MAKERS-DEVELOPMENT-GROUP/MDG-ENDER-3-PRO_V2-PROJECT/BOM/MDG ENDER 3 PRO_V2 - BOM R0.xlsx

Sheet: READ ME
Thank you for your interest in MAKERS DEVELOPMENT GROUP, LLC'S ENDER 3 PRO / V2 upgrade project.
AQUIRING PARTS FOR THE BUILD
There are many ways to build your MDG ENDER 3.
1.) Buy a Complete Kit directly from our webstore
This is the easiset option as all required parts will come from a single purchase from our webstore.
As such this is our recommneded option.
2.) Buy each axis upgrade individually from our webstore
This is the option if you wish to upgrade over time. If you go down this path we recommend upgrading
the Y-axis first, X-axis second, and Z-axis third. You can purchase each axis upgrade kit directly from our webstore
3.) Buy aluminum parts & 3D printed parts kit from our store.
This option is for those that enjoy sourcing all the componets themselves.
Please use our affiliate links so you can support our business and enable us to provide more designs.
For amazon links please note the link expires after 24 hours so please make your purchase within that
time period so we can get credit or re-click links prior to purchase.
4.) Buy aluminum parts from our webstore & 3D print your own parts
This option is for those that enjoy sourcing all the componets and printing their own parts.
Please use our affiliate links so the can support our business and enable us to provide more designs.
For amazon links please note the link expires after 24 hours so please make your purchase within that
time period so we can get credit or re-click links prior to purchase.
***********************************************************************************************
Please note MDG makes all our own aluminum parts, we do not allow others to make them on our
behalf, please support our business by buying all aluminum parts directly from us. Reverse
engineering of any MDG parts is forebidden.
See LEGAL section for full tems of use pertaining to this BOM

Sheet: MDG ENDER 3 PRO_V2 - BOM
MAKERS DEVELOPMENT GROUP, LLC
MDG ENDER 3 PRO / V2 PROJECT - BILL OF MATERIAL
REV: 0
ITEM | QTY | PART NUMBER | DESCRIPTION | COST | EXT COST
 | 1 | 10-0008 | MDG X-AXIS TIMING BELT CLAMP (https://www.makersdevelopmentgroup.com/product-page/gt2-timing-belt-clamp-vertical-6mm) | $3.93 | $3.93
 | 3 | 10-0009 | MDG Z AXIS SPACER (https://www.makersdevelopmentgroup.com/product-page/mdg-z-axis-spacer-cr-10) | $4.95 | $14.85
 | 1 | 10-0012 | MDG Z RAIL UPPER SUPPORT, LEFT, CR10 / ENDER 3 | 3.53 | $3.53
 | 1 | 10-0013 | MDG Z RAIL UPPER SUPPORT, RIGHT, CR10 / ENDER 3 | 3.53 | $3.53
 | 1 | 10-0022 | MDG DUAL-X LINEAR RAIL PLATE, 300 MM, ENDER 3 | 59.95 | $59.95
 | 1 | 10-0023 | MDG-TOOL BASE, DUAL-X, ENDER 3 | 24.95 | $24.95
 | 1 | 10-0024 | DIRECT DRIVE EXTRUDER MOUNT, ENDER 3 / CR-10 / MICRO-SWISS | 13.95 | $13.95
 | 2 | 10-0026 | MDG DUAL-Y LINEAR RAIL MOUNT L&R, ENDER 3 PRO LW | 37.95 | $37.95
 | 2 | 10-0027 | MDG DUAL-Y END STOP, ENDER 3 PRO / V2 | 3.53 | $7.06
 | 1 | 10-0028 | MDG ADJUSTABLE Y LIMIT SWITCH PLATE, ENDER 3 PRO / V2 | 3.53 | $3.53
 | 1 | 10-0040 | MDG X END STOP, LEFT, ENDER 3 PRO / V2 | 3.53 | $3.53
 | 2 | 10-0041 | MDG X END STOP, RIGHT, ENDER 3 PRO / V2 | 3.53 | $7.06
 | 1 | 10-0042 | MDG X LIMIT SWITCH PLATE, ENDER 3 PRO / V2 | 3.53 | $3.53
 | 1 | 10-0044 | MDG Z RAIL LOWER SUPPORT, LEFT, ENDER 3 PRO / V2 | 3.53 | $3.53
 | 1 | 10-0045 | MDG Z RAIL LOWER SUPPORT, RIGHT, ENDER 3 PRO / V2 | 3.53 | $3.53
 | 2 | 98952A114 | HEX STANDOFF (https://www.mcmaster.com/98952A114/) | 1.84 | $3.68
 | 1 | GT2B-2P-6W-1M | GT2 BELT (https://amzn.to/38wEzzP) | $13.99 | $13.99
 | 30 | HLN-M3X0.5 | HEX LOCK NUT (https://amzn.to/35UMeI6) | $6.99 | $6.99
 | 3 | HLN-M5X0.8 | HEX LOCK NUT (https://amzn.to/3pOCWFH) | $8.19 | $8.19
 | 1 | HLN-M6X1 | HEX LOCK NUT (https://amzn.to/3ft75W0) | $6.28 | $6.28
 | 2 | M119A2A153 | SHCS | $10.59 | $10.59
 | 8 | M119A2A159 | SHCS (https://amzn.to/2KQQvEC) | $8.19 | $8.19
 | 86 | M119A2A161 | SHCS (https://amzn.to/2WPxBQV) | $7.89 | $7.89
 | 7 | M119A2A163 | SHCS (https://amzn.to/35WZcoV) | $8.98 | $8.98
 | 12 | M119A2A178 | SHCS (https://amzn.to/398aKaN) | $11.79 | $11.79
 | 2 | M119A2A179 | SHCS (https://amzn.to/38CBIFw) | $8.49 | $8.49
 | 3 | M119A2A188 | SHCS (https://amzn.to/35UjjUH) | $10.59 | $10.59
 | 16 | M121A2A161 | FHCS (https://amzn.to/2KyT4eC) | $6.29 | $6.29
 | 6 | M121A2A163 | FHCS (https://amzn.to/2Jhz8MC) | $6.69 | $6.69
 | 4 | M12A5C3 | PLAIN WASHER (https://amzn.to/3nUd3T7) | $4.99 | $4.99
 | 4 | M12A5C5 | PLAIN WASHER (https://amzn.to/3kXEGbZ) | $7.29 | $7.29
 | 2 | MDG-LR09-1H-300 | LINEAR RAIL, 9MM X 300MM, SS (https://amzn.to/3plMVkD) | 21.99 | $43.98
 | 2 | MDG-LR-12-1H-300 | LINEAR RAIL, 12MM X 300MM (https://amzn.to/2KpyL3j) | 19.99 | $39.98
 | 2 | MDG-LR12-1H-350 | LINEAR RAIL, 12MM X 350MM (https://amzn.to/3nNH7jn) | 21.99 | $43.98
 | 1 | SB-A201 | SHOULDER BOLT (https://www.mcmaster.com/92981A201/) | $1.57 | $1.57
 | 1 | SBS-A263 | SHIM (https://www.mcmaster.com/91437A263/) | $9.60 | $9.60
 | 1 | SBS-A282 | SHIM (https://www.mcmaster.com/91437A282/) | $12.75 | $12.75
 | 52 | TN-2020-M3 | T-NUT, 2020 (https://amzn.to/3pWzc55) | $7.99 | $7.99
 | 10 | TN-2020-M5 | T-NUT, 2020 (https://amzn.to/2IViW3E) | $7.99 | $7.99
 |  |  |  |  | $493.16

Sheet: LEGAL
LEGAL TERMS
THIS BILL OF MATERIAL AND DATA EMBODY PROPRIETARY INFORMATION WHICH IS THE CONFIDENTIAL
PROPERTY OF MAKERS DEVELOPMENT GROUP, LLC AND SHALL NOT BE COPIED, REPRODUCED, DISCLOSED
TO OTHERS, OR OTHERWISE USED IN WHOLE OR IN PART IN ANY MATTER PREJUDICIAL TO THE
INTERESTS OF MAKERS DEVELOPMENT GROUP, LLC WITHOUT EXPRESS WRITTEN CONSENT OF MAKERS
DEVELOPMENT GROUP, LLC. MAKERS DEVELOPMENT GROUP, LLC EXPRESSLY RESERVES ALL DESIGN,
MANUFACTURING USE, REPRODUCTION AND SALES RIGHTS IN AND TO ALL INFORMATION CONTAINED IN
OR DISCLOSED BY THIS DOCUMENT. THIS BILL OF MATERIAL IS LOANED IN CONFIDENCE WITH THE
UNDERSTANDING IT SHALL BE RETURNED ON DEMAND. ACCEPTANCE OF THIS BILL OF MATERIAL SHALL
BE CONSTRUED AS AN AGREEMENT TO OBSERVE THE FOREGOING CONDITIONS AND AS AN ADMISSION
THAT MAKERS DEVELOPMENT GROUP, LLCIS THE EXCLUSIVE OWNER OF THIS BILL OF MATERIAL.
"MAKERS DEVELOPMENT GROUP, LLCEXPRESSLY RESERVES ALL DESIGN, MANUFACTURING USE,
REPRODUCTION, SALES RIGHTS IN AND TO ALL INFORMATION CONTAINED OR DISCLOSED BY THIS
DOCUMENT."
