MAKERS-DEVELOPMENT-GROUP/MDG-ENDER-3-PRO_V2-PROJECT/STL/10-0024#2.stl

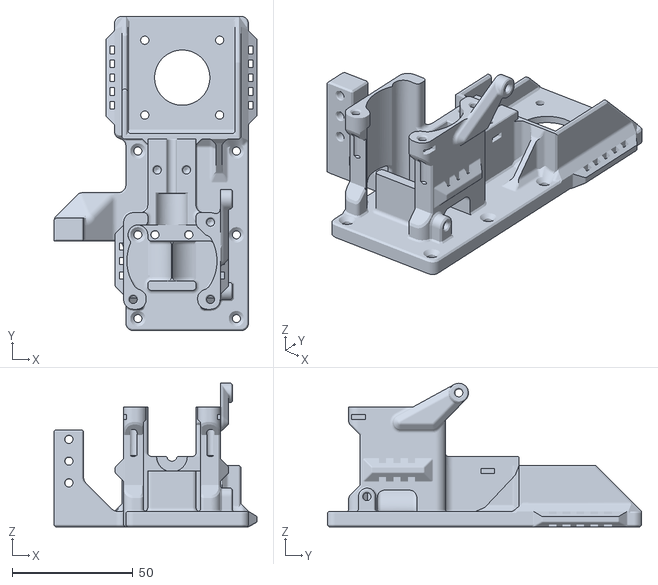
[picture p2: CAD file, 2021-04-25]
STL/10-0024#2.stl
84.0 x 130.2 x 59.4
