MAKERS-DEVELOPMENT-GROUP/MDG-ENDER-3-PRO_V2-PROJECT/STL/10-0024#1.stl

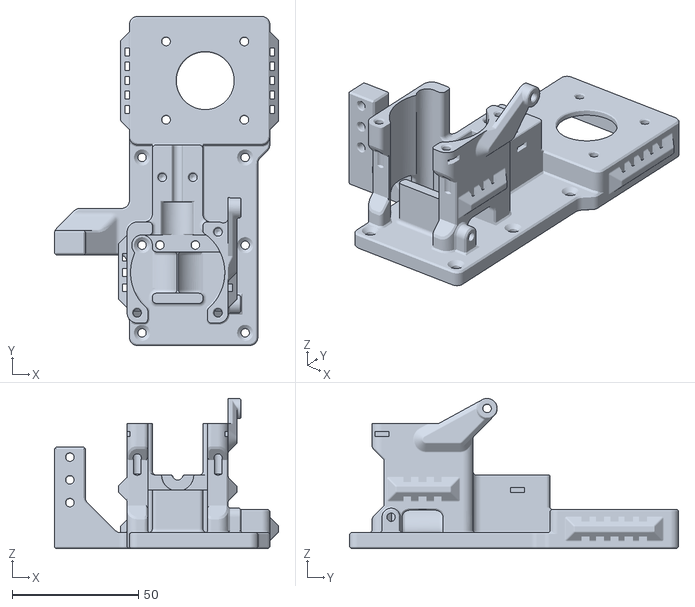
[picture p3: CAD file, 2021-04-25]
STL/10-0024#1.stl
88.8 x 130.2 x 59.4
