MAKERS-DEVELOPMENT-GROUP/MDG-ENDER-3-PRO_V2-PROJECT/STL/10-0024B#0.stl

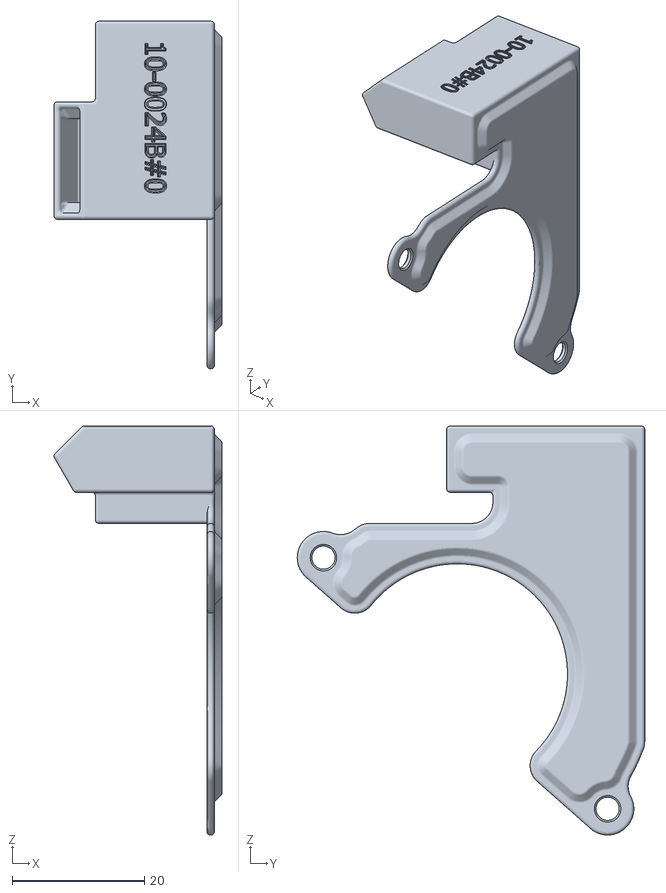
[picture p4: CAD file, 2021-04-25]
STL/10-0024B#0.stl
25.4 x 52.6 x 61.9
