MAKERS-DEVELOPMENT-GROUP/MDG-ENDER-3-PRO_V2-PROJECT/STL/10-0024A#0.stl

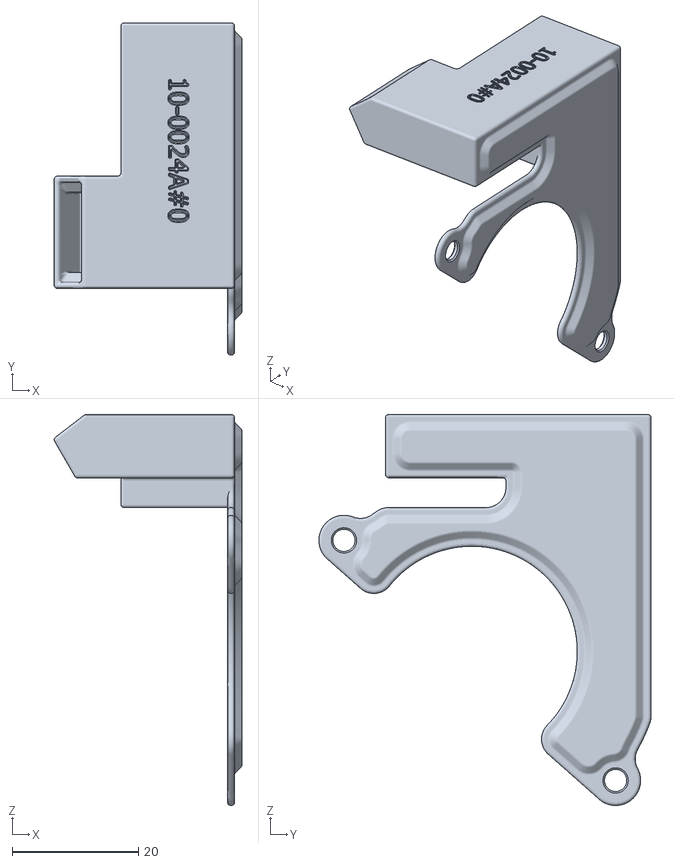
[picture p6: CAD file, 2021-04-25]
STL/10-0024A#0.stl
29.7 x 52.6 x 61.9
