MAKERS-DEVELOPMENT-GROUP/MDG-ENDER-3-PRO_V2-PROJECT/STL/10-0045.stl

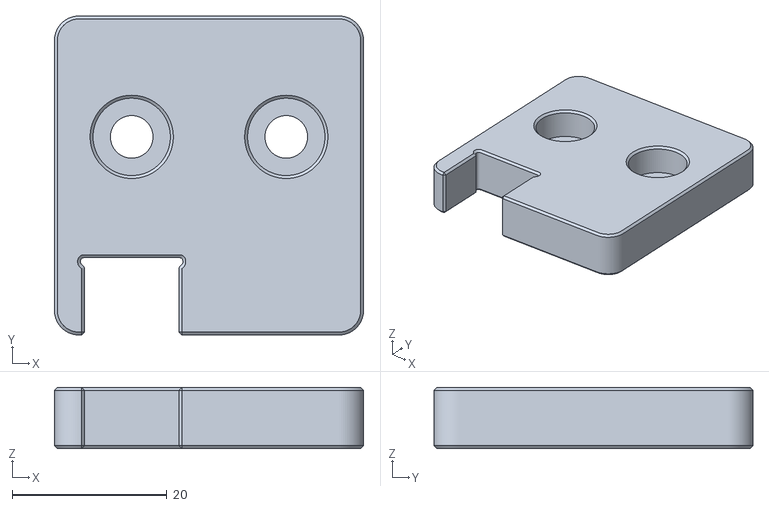
[picture p7: CAD file, 2021-02-17]
STL/10-0045.stl
40.0 x 41.3 x 7.94
