MAKERS-DEVELOPMENT-GROUP/MDG-ENDER-3-PRO_V2-PROJECT/STL/10-0012.stl

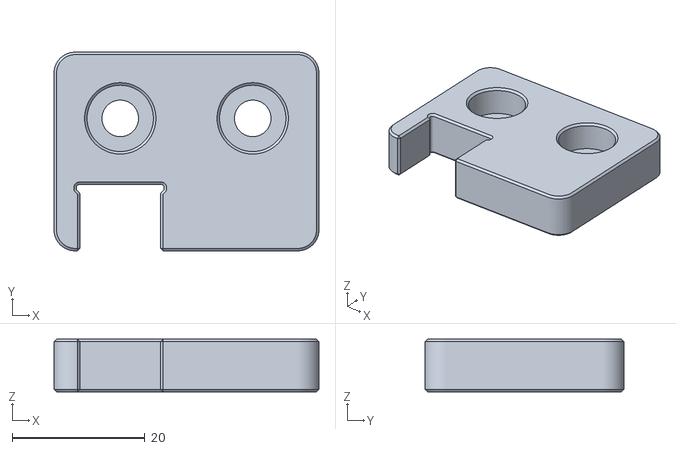
[picture p8: CAD file, 2021-02-17]
STL/10-0012.stl
40.0 x 30.0 x 7.94
