MAKERS-DEVELOPMENT-GROUP/MDG-ENDER-3-PRO_V2-PROJECT/STL/10-0041.stl

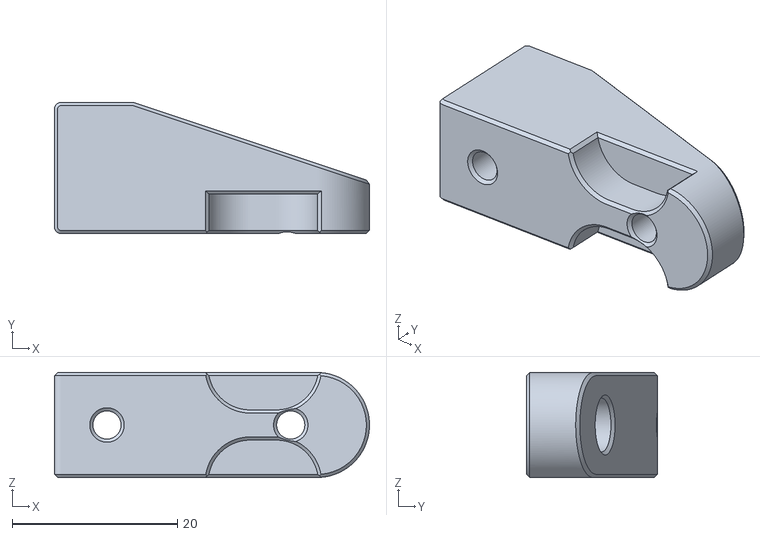
[picture p9: CAD file, 2021-02-17]
STL/10-0041.stl
38.1 x 15.9 x 12.7
