MAKERS-DEVELOPMENT-GROUP/MDG-ENDER-3-PRO_V2-PROJECT/STL/10-0028.stl

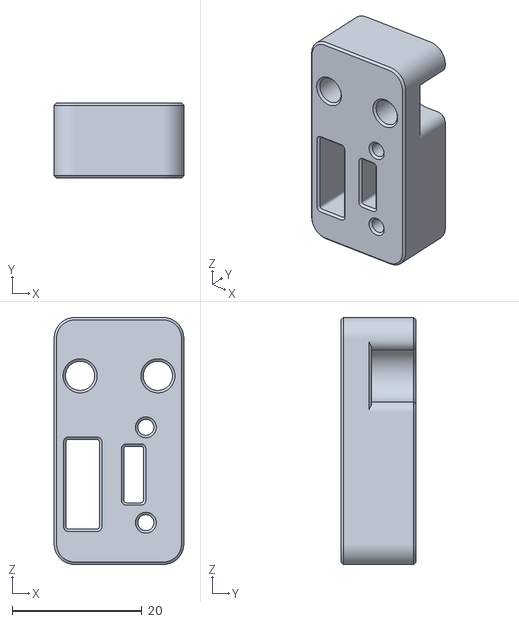
[picture p10: CAD file, 2021-02-17]
STL/10-0028.stl
20.0 x 11.6 x 38.1
