MAKERS-DEVELOPMENT-GROUP/MDG-ENDER-3-PRO_V2-PROJECT/STL/10-0040.stl

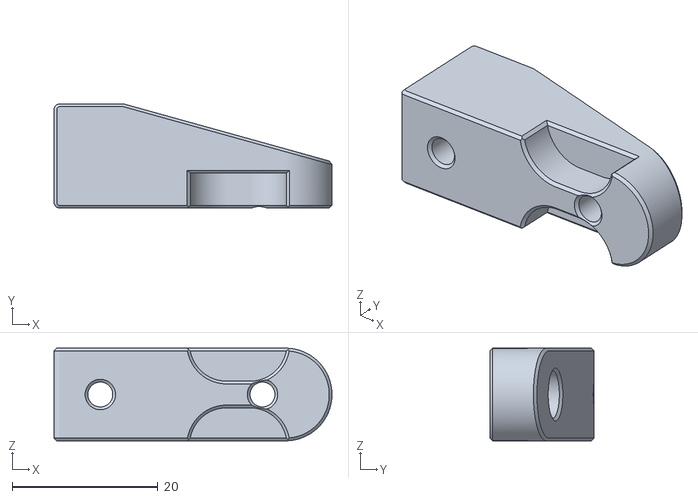
[picture p11: CAD file, 2021-02-17]
STL/10-0040.stl
38.1 x 14.3 x 12.7
