MAKERS-DEVELOPMENT-GROUP/MDG-ENDER-3-PRO_V2-PROJECT/STL/10-0043.stl

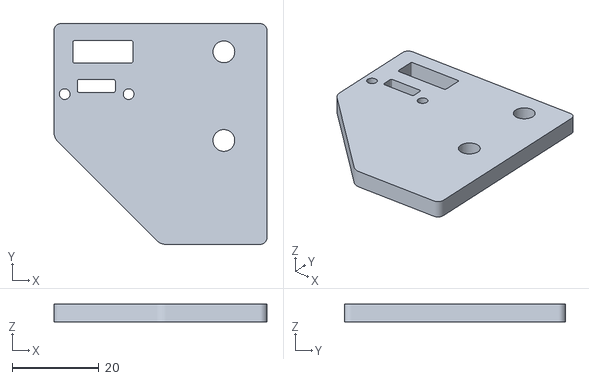
[picture p12: CAD file, 2021-02-17]
STL/10-0043.stl
49.0 x 50.8 x 4.06
