MAKERS-DEVELOPMENT-GROUP/MDG-ENDER-3-PRO_V2-PROJECT/STL/10-0024A#1.stl

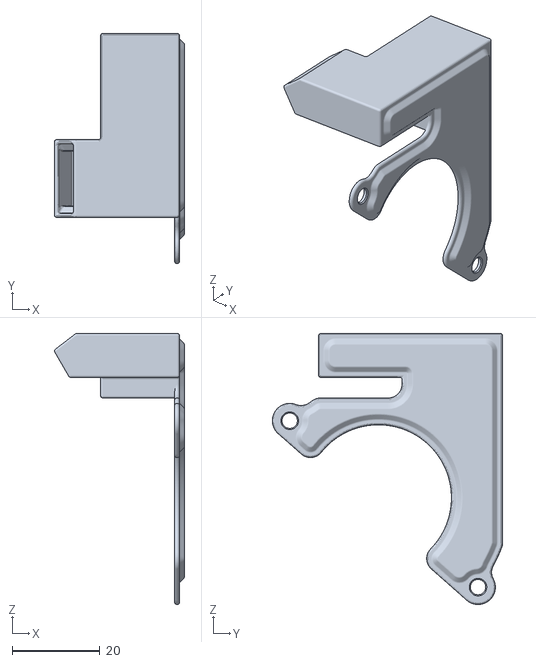
[picture p13: CAD file, 2021-02-17]
STL/10-0024A#1.stl
29.7 x 52.6 x 61.9
