MAKERS-DEVELOPMENT-GROUP/MDG-ENDER-3-PRO_V2-PROJECT/STL/10-0042.stl

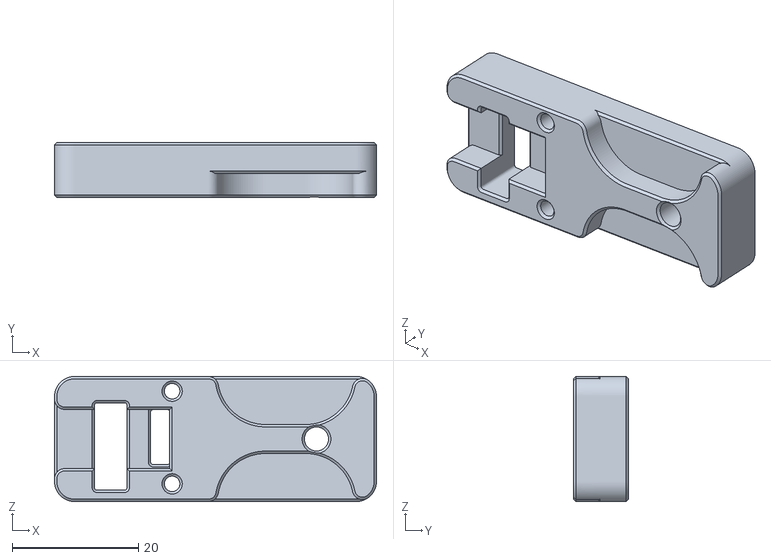
[picture p14: CAD file, 2021-02-17]
STL/10-0042.stl
51.1 x 8.73 x 19.8
