MAKERS-DEVELOPMENT-GROUP/MDG-ENDER-3-PRO_V2-PROJECT/STL/10-0027.stl

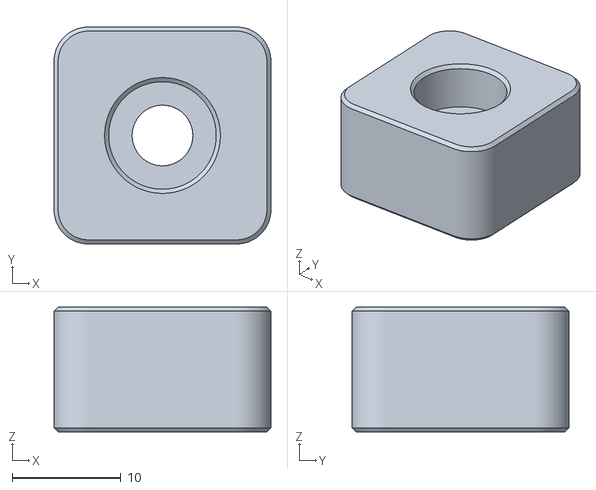
[picture p15: CAD file, 2021-02-17]
STL/10-0027.stl
20.0 x 20.0 x 11.5
