MAKERS-DEVELOPMENT-GROUP/MDG-ENDER-3-PRO_V2-PROJECT/STL/10-0048.stl

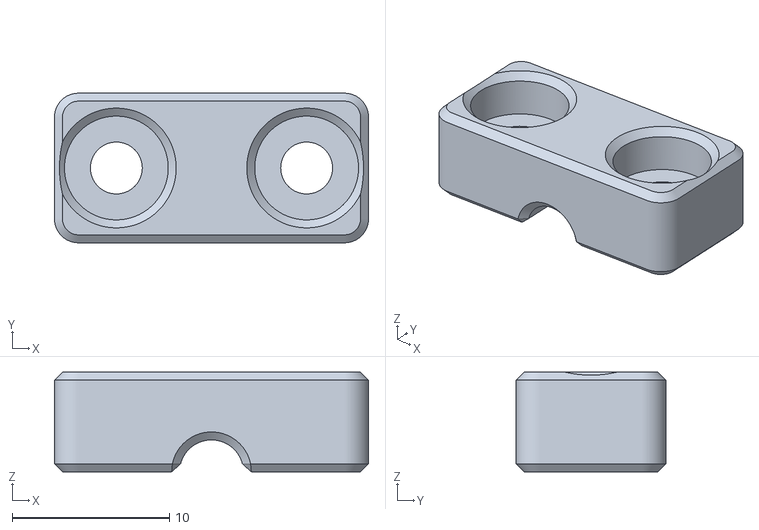
[picture p16: CAD file, 2021-02-17]
STL/10-0048.stl
20.0 x 9.52 x 6.35
