MAKERS-DEVELOPMENT-GROUP/MDG-ENDER-3-PRO_V2-PROJECT/STL/10-0049.stl

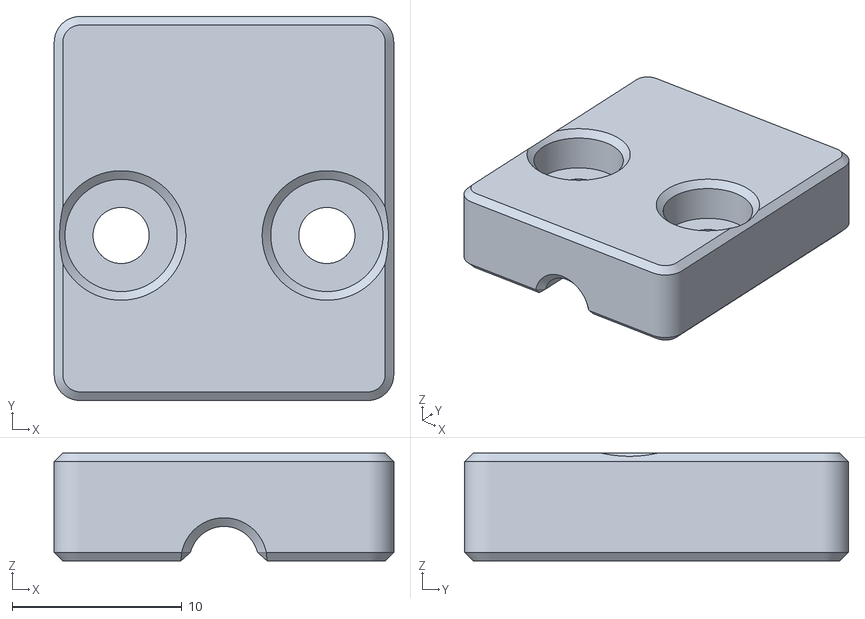
[picture p17: CAD file, 2021-02-17]
STL/10-0049.stl
20.0 x 22.6 x 6.35
