MAKERS-DEVELOPMENT-GROUP/MDG-ENDER-3-PRO_V2-PROJECT/STL/10-0050.stl

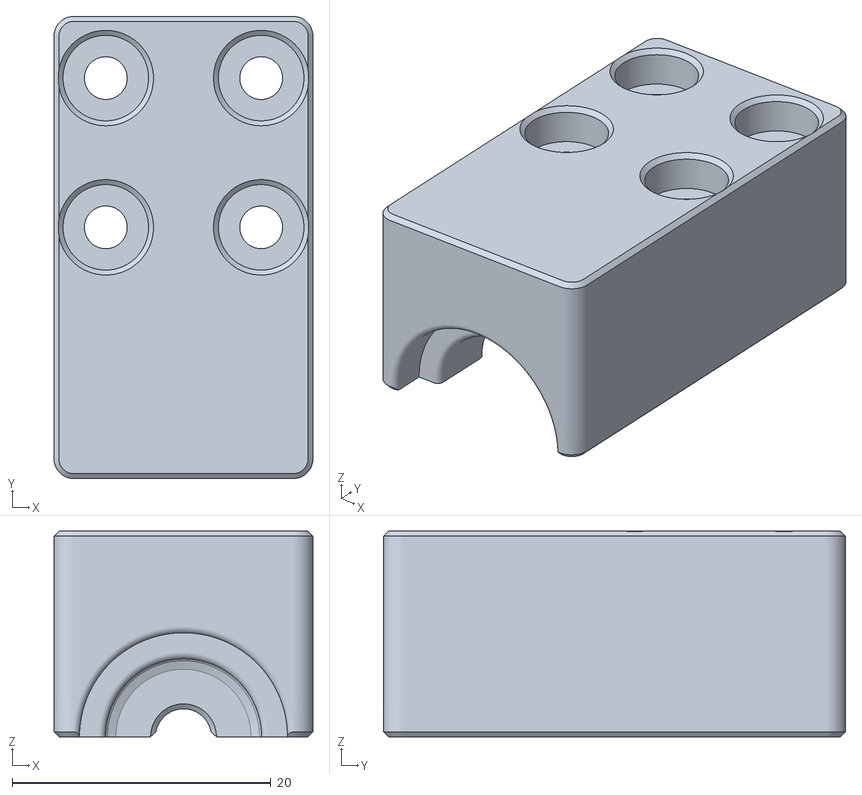
[picture p18: CAD file, 2021-02-17]
STL/10-0050.stl
20.0 x 35.7 x 15.9
