MAKERS-DEVELOPMENT-GROUP/MDG-ENDER-3-PRO_V2-PROJECT/(list of files, cad)

Other CAD files:
STL/10-0024#3.stl
STL/10-0024#4.stl
STL/10-0044.stl
STL/10-0013.stl
