MAKERS-DEVELOPMENT-GROUP/MDG-ENDER-3-PRO_V2-PROJECT/ASSEMBLY DRAWINGS/10-0057.pdf

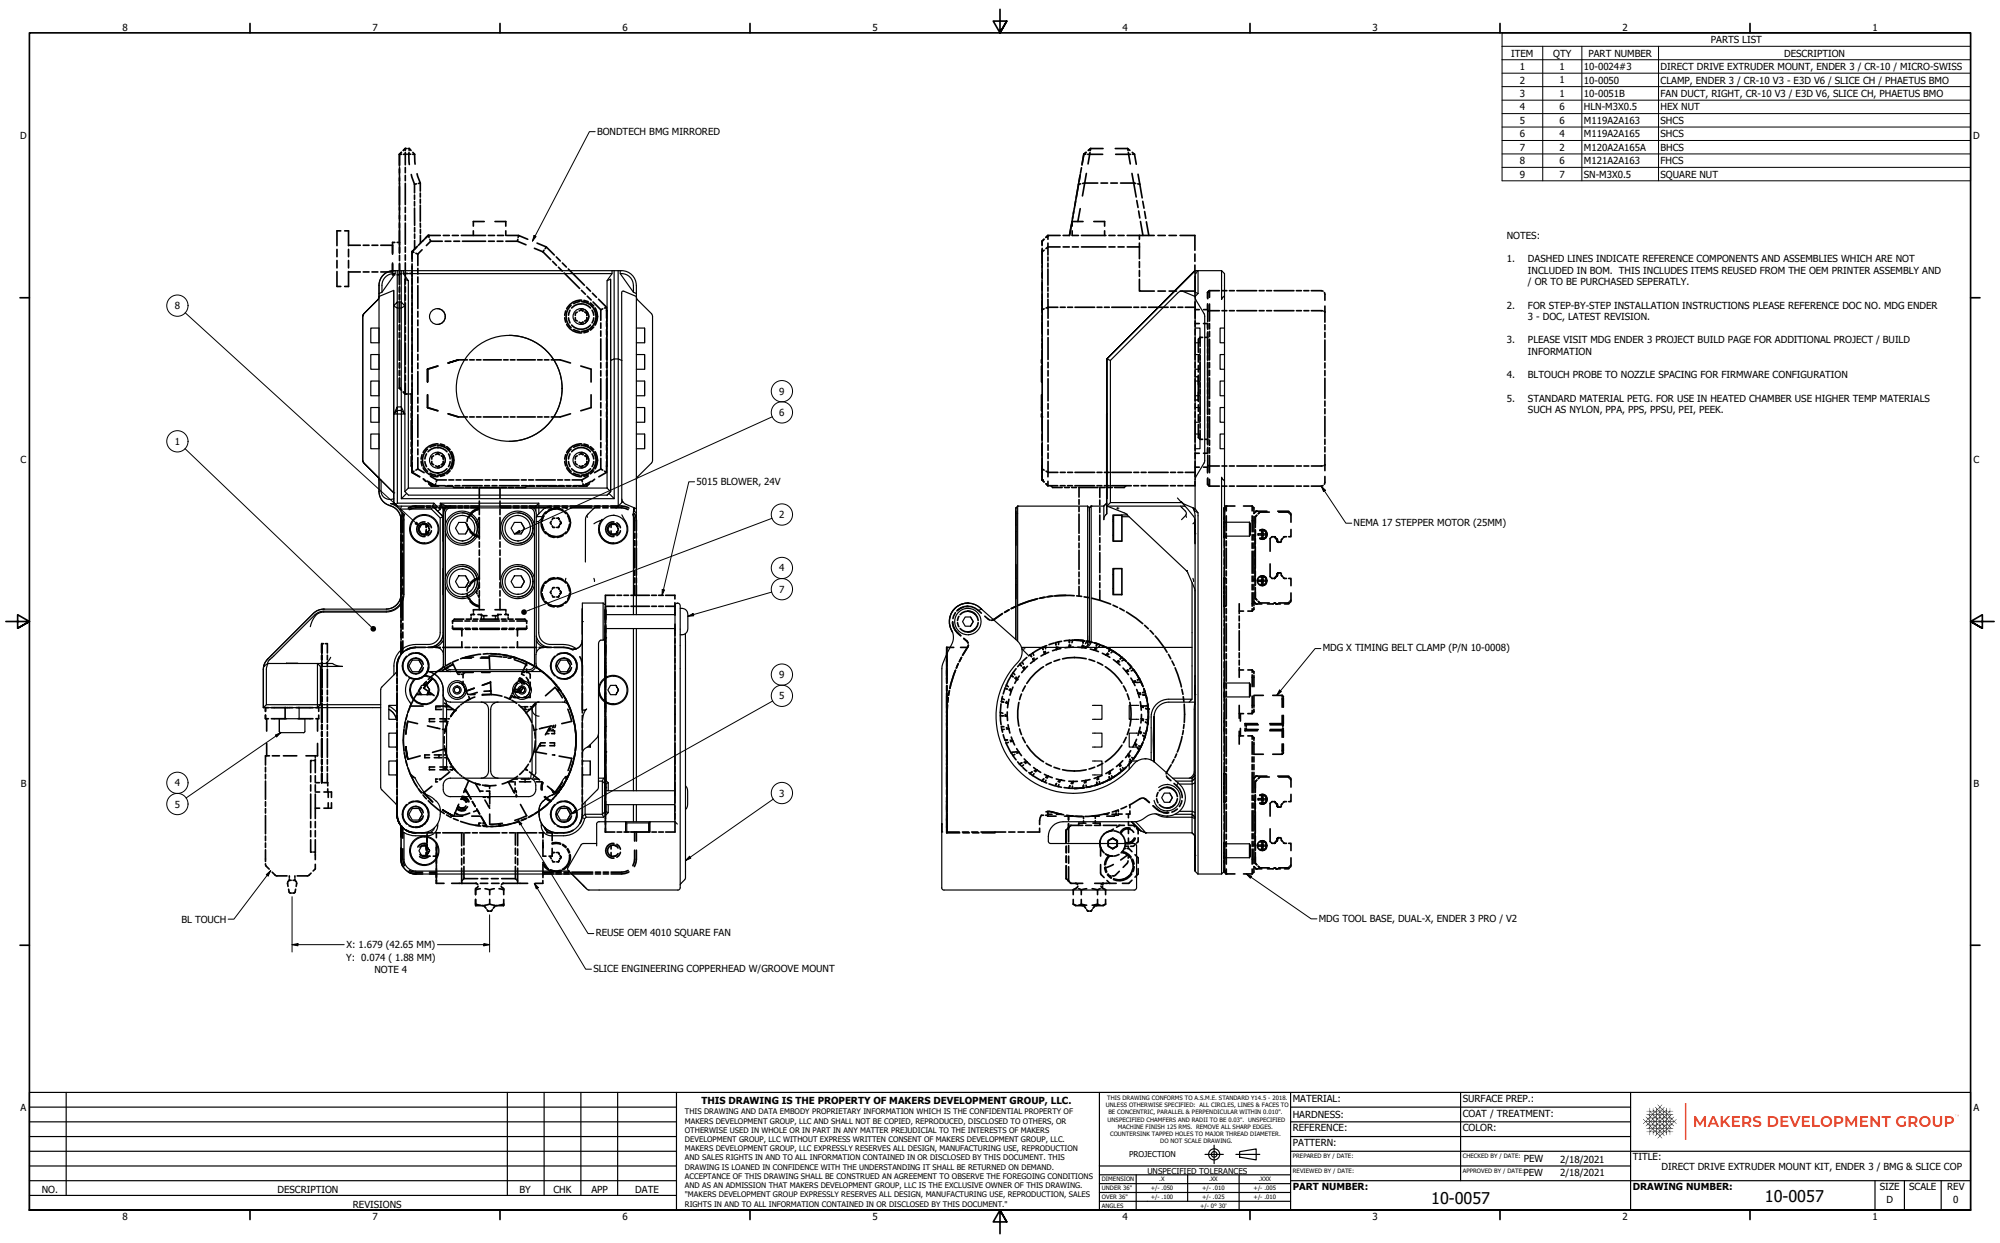
[picture p19: page 1]
PART NUMBER:; DRAWING NUMBER:; REV; SURFACE PREP.:; 5015 BLOWER, 24V; X: 1.679 (42.65 MM) Y: 0.074 ( 1.88 MM) NOTE 4; BL TOUCH

PARTS LIST

ITEM | QTY | PART NUMBER | DESCRIPTION
1 | 1 | 10-0024#3 | DIRECT DRIVE EXTRUDER MOUNT, ENDER 3 / CR-10 / MICRO-SWISS
2 | 1 | 10-0050 | CLAMP, ENDER 3 / CR-10 V3 - E3D V6 / SLICE CH / PHAETUS BMO
3 | 1 | 10-0051B | FAN DUCT, RIGHT, CR-10 V3 / E3D V6, SLICE CH, PHAETUS BMO
4 | 6 | HLN-M3X0.5 | HEX NUT
5 | 6 | M119A2A163 | SHCS
6 | 4 | M119A2A165 | SHCS
7 | 2 | M120A2A165A | BHCS
8 | 6 | M121A2A163 | FHCS
9 | 7 | SN-M3X0.5 | SQUARE NUT

BONDTECH BMG MIRRORED

1. DASHED LINES INDICATE REFERENCE COMPONENTS AND ASSEMBLIES WHICH ARE NOT
INCLUDED IN BOM. THIS INCLUDES ITEMS REUSED FROM THE OEM PRINTER ASSEMBLY AND
/ OR TO BE PURCHASED SEPERATLY.

2. FOR STEP-BY-STEP INSTALLATION INSTRUCTIONS PLEASE REFERENCE DOC NO. MDG ENDER
3 - DOC, LATEST REVISION.

3. PLEASE VISIT MDG ENDER 3 PROJECT BUILD PAGE FOR ADDITIONAL PROJECT / BUILD
INFORMATION

4. BLTOUCH PROBE TO NOZZLE SPACING FOR FIRMWARE CONFIGURATION

5. STANDARD MATERIAL PETG. FOR USE IN HEATED CHAMBER USE HIGHER TEMP MATERIALS
SUCH AS NYLON, PPA, PPS, PPSU, PEI, PEEK.

NEMA 17 STEPPER MOTOR (25MM)

MDG X TIMING BELT CLAMP (P/N 10-0008)

MDG TOOL BASE, DUAL-X, ENDER 3 PRO / V2

REUSE OEM 4010 SQUARE FAN

SLICE ENGINEERING COPPERHEAD W/GROOVE MOUNT

THIS DRAWING CONFORMS TO A.S.M.E. STANDARD Y14.5 - 2018.
UNLESS OTHERWISE SPECIFIED: ALL CIRCLES, LINES & FACES TO
BE CONCENTRIC, PARALLEL & PERPENDICULAR WITHIN 0.010".
UNSPECIFIED CHAMFERS AND RADII TO BE 0.03". UNSPECIFIED
MACHINE FINISH 125 RMS. REMOVE ALL SHARP EDGES.
COUNTERSINK TAPPED HOLES TO MAJOR THREAD DIAMETER.

THIS DRAWING IS THE PROPERTY OF MAKERS DEVELOPMENT GROUP, LLC.
THIS DRAWING AND DATA EMBODY PROPRIETARY INFORMATION WHICH IS THE CONFIDENTIAL PROPERTY OF
MAKERS DEVELOPMENT GROUP, LLC AND SHALL NOT BE COPIED, REPRODUCED, DISCLOSED TO OTHERS, OR
OTHERWISE USED IN WHOLE OR IN PART IN ANY MATTER PREJUDICIAL TO THE INTERESTS OF MAKERS
DEVELOPMENT GROUP, LLC WITHOUT EXPRESS WRITTEN CONSENT OF MAKERS DEVELOPMENT GROUP, LLC.
MAKERS DEVELOPMENT GROUP, LLC EXPRESSLY RESERVES ALL DESIGN, MANUFACTURING USE, REPRODUCTION
AND SALES RIGHTS IN AND TO ALL INFORMATION CONTAINED IN OR DISCLOSED BY THIS DOCUMENT. THIS
DRAWING IS LOANED IN CONFIDENCE WITH THE UNDERSTANDING IT SHALL BE RETURNED ON DEMAND.
ACCEPTANCE OF THIS DRAWING SHALL BE CONSTRUED AN AGREEMENT TO OBSERVE THE FOREGOING CONDITIONS
AND AS AN ADMISSION THAT MAKERS DEVELOPMENT GROUP, LLC IS THE EXCLUSIVE OWNER OF THIS DRAWING.
"MAKERS DEVELOPMENT GROUP EXPRESSLY RESERVES ALL DESIGN, MANUFACTURING USE, REPRODUCTION, SALES
RIGHTS IN AND TO ALL INFORMATION CONTAINED IN OR DISCLOSED BY THIS DOCUMENT."

HARDNESS: | COAT / TREATMENT:
REFERENCE: | COLOR:
PATTERN:
PREPARED BY / DATE: | CHECKED BY / DATE: PEW 2/18/2021 | TITLE: DIRECT DRIVE EXTRUDER MOUNT KIT, ENDER 3 / BMG & SLICE COP

DO NOT SCALE DRAWING.

UNSPECIFIED TOLERANCES | REVIEWED BY / DATE: | APPROVED BY / DATE: PEW 2/18/2021

DIMENSION | .X | .XX | .XXX
UNDER 36" | +/- .050 | +/- .010 | +/- .005
OVER 36" | +/- .100 | +/- .025 | +/- .010
ANGLES | +/- 0° 30'
