MAKERS-DEVELOPMENT-GROUP/MDG-ENDER-3-PRO_V2-PROJECT/ASSEMBLY DRAWINGS/10-0036.pdf

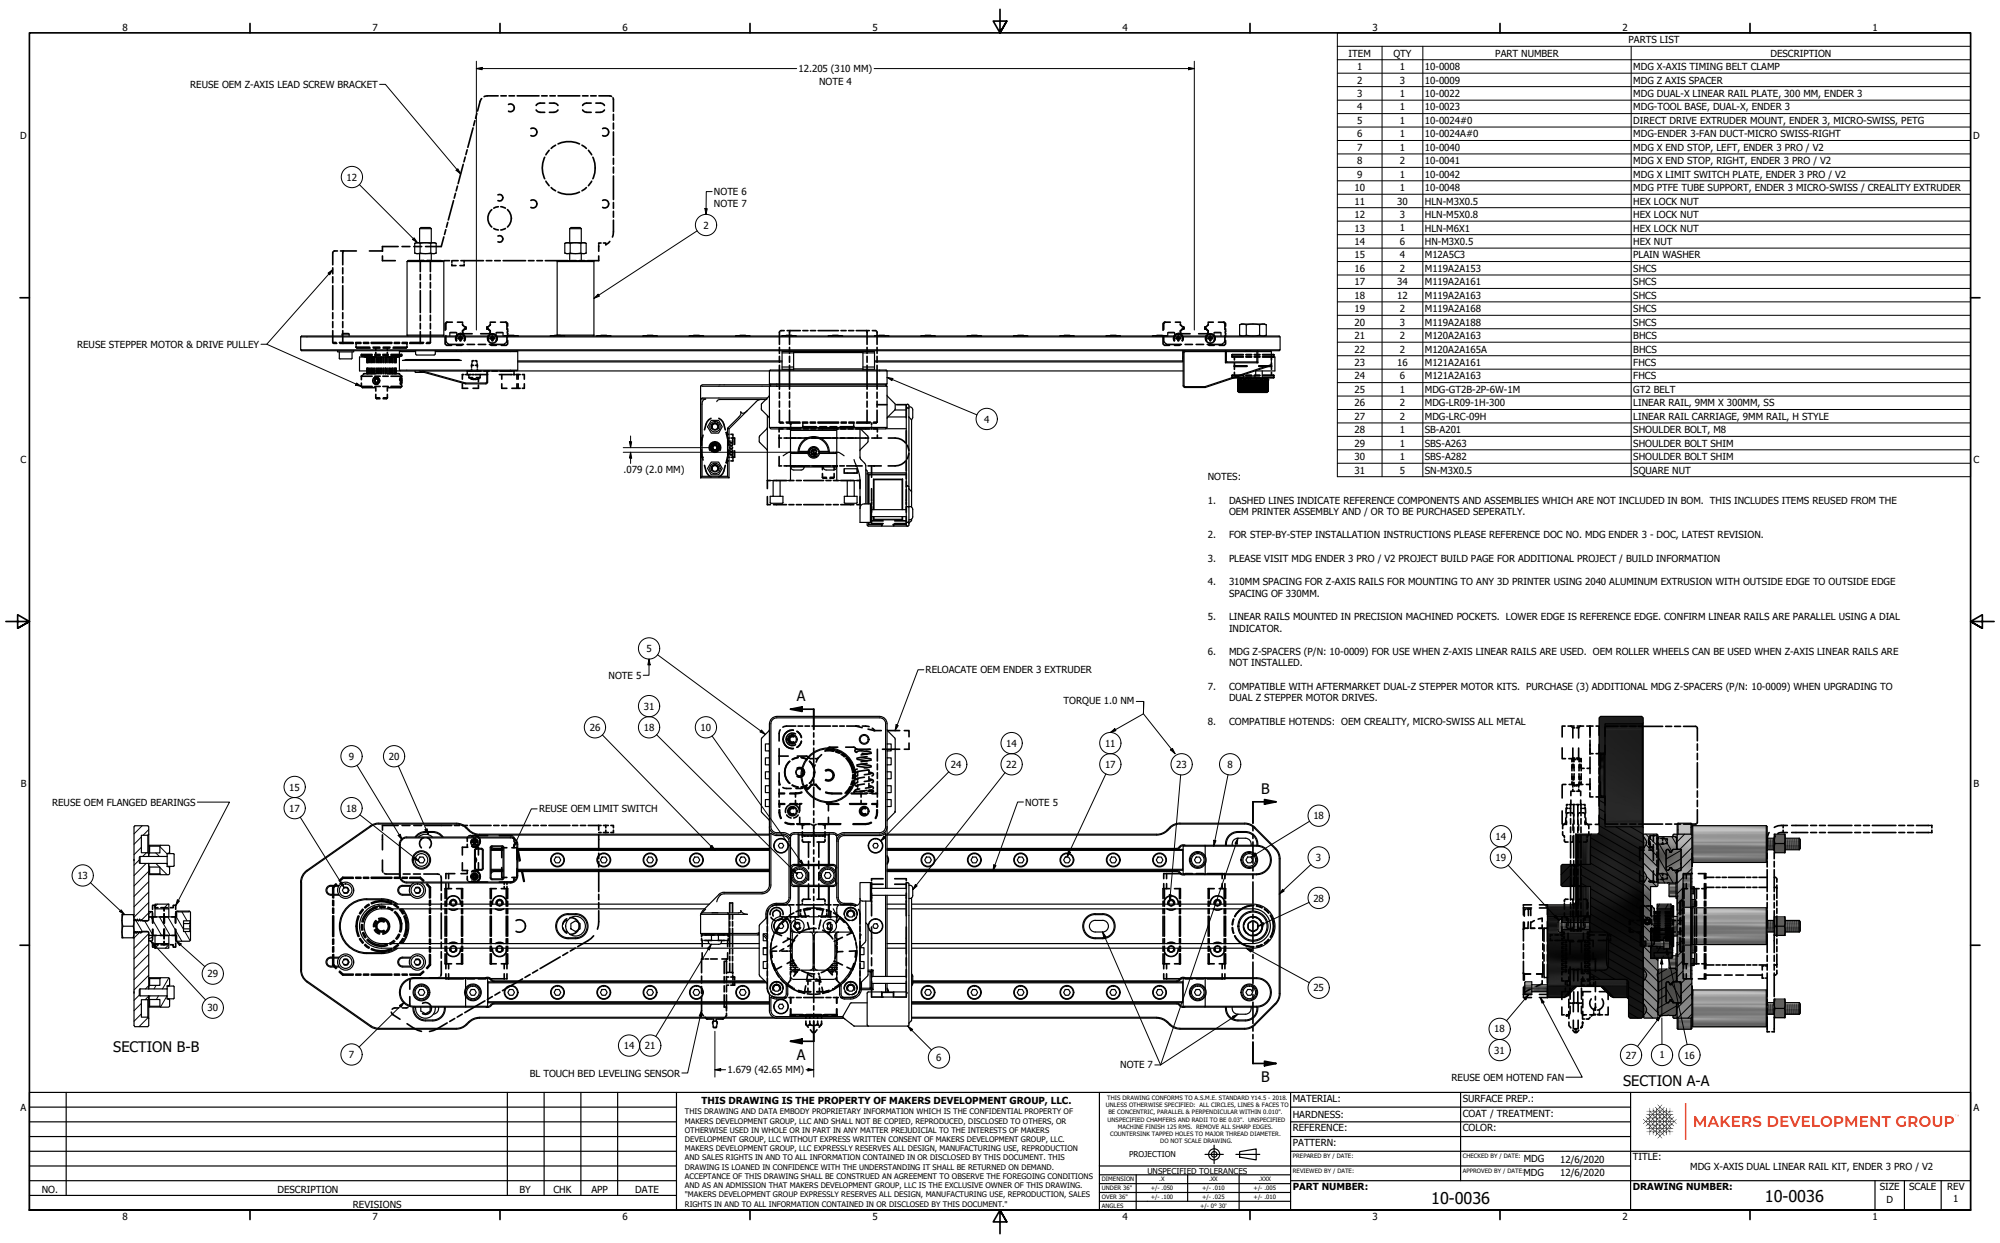
[picture p20: page 1]
SECTION A-A; SECTION B-B; PARTS LIST; ITEM; QTY; PART NUMBER; DESCRIPTION; MDG X-AXIS TIMING BELT CLAMP; MDG Z AXIS SPACER; MDG DUAL-X LINEAR RAIL PLATE, 300 MM, ENDER 3; MDG-TOOL BASE, DUAL-X, ENDER 3; DIRECT DRIVE EXTRUDER MOUNT, ENDER 3, MICRO-SWISS, PETG; MDG-ENDER 3-FAN DUCT-MICRO SWISS-RIGHT; MDG X END STOP, LEFT, ENDER 3 PRO / V2; MDG X END STOP, RIGHT, ENDER 3 PRO / V2; MDG X LIMIT SWITCH PLATE, ENDER 3 PRO / V2; MDG PTFE TUBE SUPPORT, ENDER 3 MICRO-SWISS / CREALITY EXTRUDER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

REUSE OEM Z-AXIS LEAD SCREW BRACKET

REUSE STEPPER MOTOR & DRIVE PULLEY

1. DASHED LINES INDICATE REFERENCE COMPONENTS AND ASSEMBLIES WHICH ARE NOT INCLUDED IN BOM. THIS INCLUDES ITEMS REUSED FROM THE
OEM PRINTER ASSEMBLY AND / OR TO BE PURCHASED SEPERATLY.

2. FOR STEP-BY-STEP INSTALLATION INSTRUCTIONS PLEASE REFERENCE DOC NO. MDG ENDER 3 - DOC, LATEST REVISION.

3. PLEASE VISIT MDG ENDER 3 PRO / V2 PROJECT BUILD PAGE FOR ADDITIONAL PROJECT / BUILD INFORMATION

4. 310MM SPACING FOR Z-AXIS RAILS FOR MOUNTING TO ANY 3D PRINTER USING 2040 ALUMINUM EXTRUSION WITH OUTSIDE EDGE TO OUTSIDE EDGE
SPACING OF 330MM.

5. LINEAR RAILS MOUNTED IN PRECISION MACHINED POCKETS. LOWER EDGE IS REFERENCE EDGE. CONFIRM LINEAR RAILS ARE PARALLEL USING A DIAL
INDICATOR.

6. MDG Z-SPACERS (P/N: 10-0009) FOR USE WHEN Z-AXIS LINEAR RAILS ARE USED. OEM ROLLER WHEELS CAN BE USED WHEN Z-AXIS LINEAR RAILS ARE
NOT INSTALLED.

RELOACATE OEM ENDER 3 EXTRUDER

7. COMPATIBLE WITH AFTERMARKET DUAL-Z STEPPER MOTOR KITS. PURCHASE (3) ADDITIONAL MDG Z-SPACERS (P/N: 10-0009) WHEN UPGRADING TO
DUAL Z STEPPER MOTOR DRIVES.

8. COMPATIBLE HOTENDS: OEM CREALITY, MICRO-SWISS ALL METAL

REUSE OEM FLANGED BEARINGS

REUSE OEM LIMIT SWITCH

BL TOUCH BED LEVELING SENSOR

REUSE OEM HOTEND FAN

THIS DRAWING CONFORMS TO A.S.M.E. STANDARD Y14.5 - 2018.
UNLESS OTHERWISE SPECIFIED: ALL CIRCLES, LINES & FACES TO
BE CONCENTRIC, PARALLEL & PERPENDICULAR WITHIN 0.010".
UNSPECIFIED CHAMFERS AND RADII TO BE 0.03". UNSPECIFIED
MACHINE FINISH 125 RMS. REMOVE ALL SHARP EDGES.
COUNTERSINK TAPPED HOLES TO MAJOR THREAD DIAMETER.

THIS DRAWING IS THE PROPERTY OF MAKERS DEVELOPMENT GROUP, LLC.
THIS DRAWING AND DATA EMBODY PROPRIETARY INFORMATION WHICH IS THE CONFIDENTIAL PROPERTY OF
MAKERS DEVELOPMENT GROUP, LLC AND SHALL NOT BE COPIED, REPRODUCED, DISCLOSED TO OTHERS, OR
OTHERWISE USED IN WHOLE OR IN PART IN ANY MATTER PREJUDICIAL TO THE INTERESTS OF MAKERS
DEVELOPMENT GROUP, LLC WITHOUT EXPRESS WRITTEN CONSENT OF MAKERS DEVELOPMENT GROUP, LLC.
MAKERS DEVELOPMENT GROUP, LLC EXPRESSLY RESERVES ALL DESIGN, MANUFACTURING USE, REPRODUCTION
AND SALES RIGHTS IN AND TO ALL INFORMATION CONTAINED IN OR DISCLOSED BY THIS DOCUMENT. THIS
DRAWING IS LOANED IN CONFIDENCE WITH THE UNDERSTANDING IT SHALL BE RETURNED ON DEMAND.
ACCEPTANCE OF THIS DRAWING SHALL BE CONSTRUED AN AGREEMENT TO OBSERVE THE FOREGOING CONDITIONS
AND AS AN ADMISSION THAT MAKERS DEVELOPMENT GROUP, LLC IS THE EXCLUSIVE OWNER OF THIS DRAWING.
"MAKERS DEVELOPMENT GROUP EXPRESSLY RESERVES ALL DESIGN, MANUFACTURING USE, REPRODUCTION, SALES
RIGHTS IN AND TO ALL INFORMATION CONTAINED IN OR DISCLOSED BY THIS DOCUMENT."

DO NOT SCALE DRAWING.

PREPARED BY / DATE:

CHECKED BY / DATE:

MDG X-AXIS DUAL LINEAR RAIL KIT, ENDER 3 PRO / V2

REVIEWED BY / DATE:
PART NUMBER:

APPROVED BY / DATE:
